RogerF5-Security/Case-Evil_Doggie/docs/PROTOTYPE_FEEDBACK.md

# Prototipo de taller

Estas fotografías documentan un **prototipo anterior de taller**. Los renders y
el visor muestran la geometría compartida, cuya impresión aún debe comprobarse.

| Observación del prototipo | Cambio en v2 |
|---|---|
| Letras exteriores poco legibles | Se retiran todas; se conserva la geometría interior existente |
| USB demasiado justo por su borde inferior | Recorte más ancho y 2 mm de rebaje adicional propuesto |
| Tornillos largos difíciles de conseguir | Eliminados: cierre con cuatro pestañas liberables |
| Ventilación insuficiente | Rejilla posterior de 14 ranuras + 8 laterales pasantes |
| DB9 visible y accesible | Se conserva su abertura nominal y su acceso |

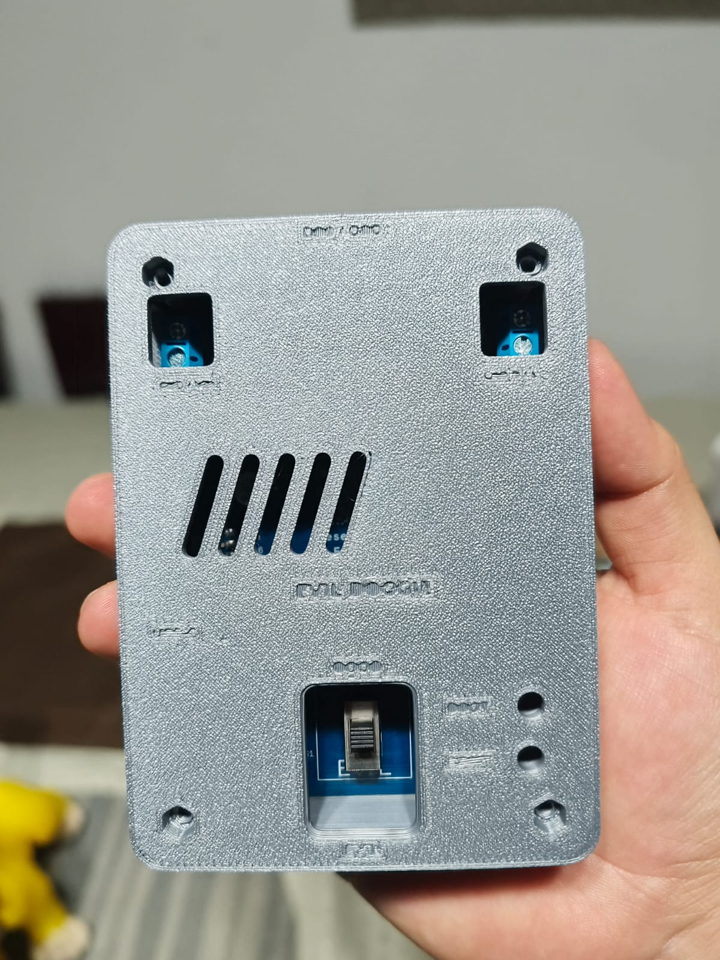
[picture p5: docs/photos/v1-controls.png]
Prototipo v1: controles y grabados pequeños


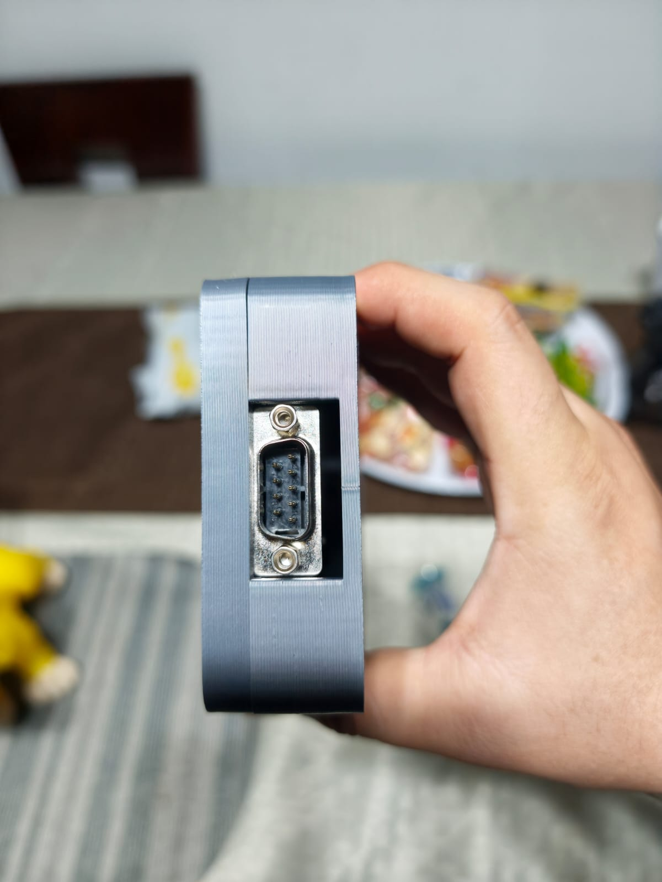
[picture p6: docs/photos/v1-db9.png]
Prototipo v1: acceso DB9


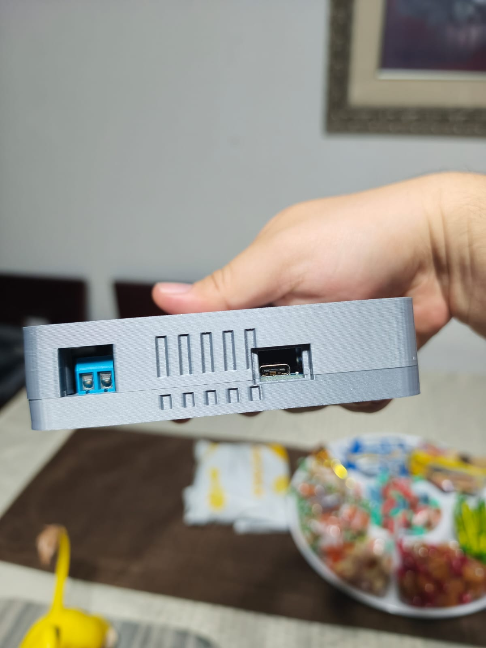
[picture p7: docs/photos/v1-usb.png]
Prototipo v1: abertura USB y rebajes laterales


La v1 tenía cinco rebajes de agarre en cada lateral; no eran pasos de aire.
El área abierta posterior de v2 se calcula directamente a partir del CAD.
El resultado térmico y la fuerza de las pestañas requieren pruebas reales.
