RogerF5-Security/Case-Evil_Doggie/assets/pcb-art.png

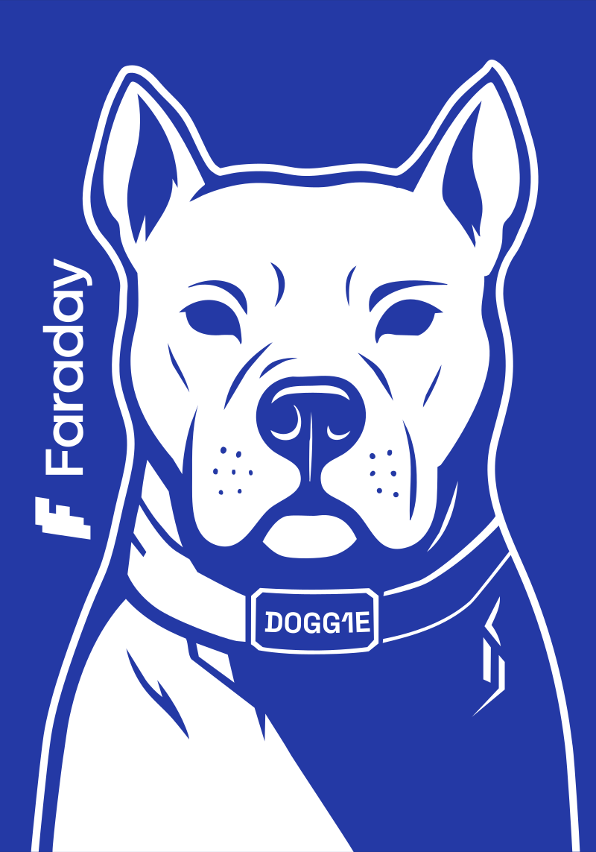
assets/pcb-art.png
