RogerF5-Security/Case-Evil_Doggie/docs/images/front.png

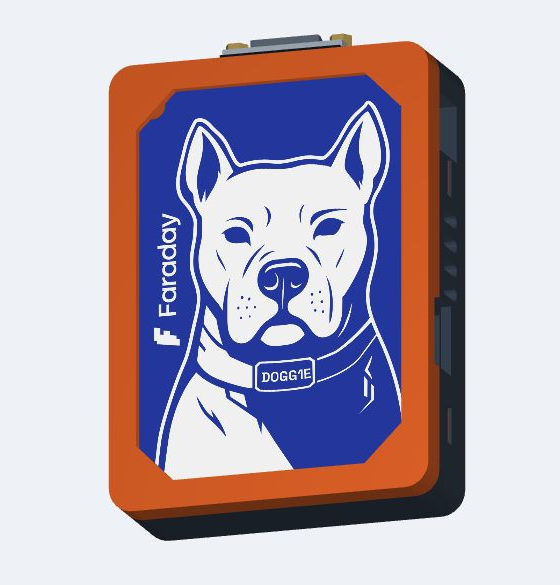
docs/images/front.png
