RogerF5-Security/Case-Evil_Doggie/docs/images/inside.png

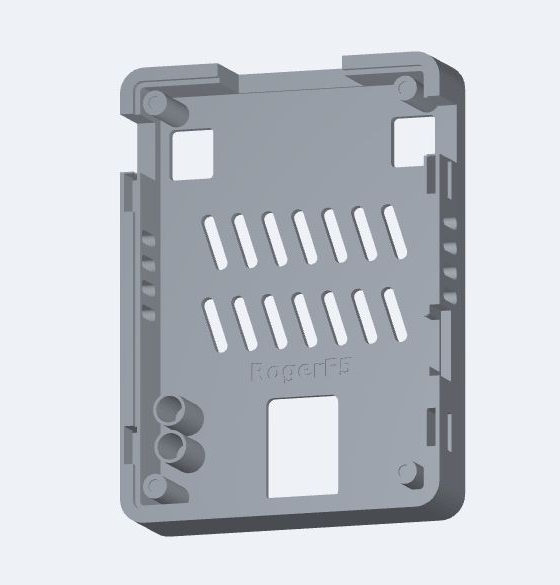
docs/images/inside.png
