RogerF5-Security/Case-Evil_Doggie/docs/images/rear.png

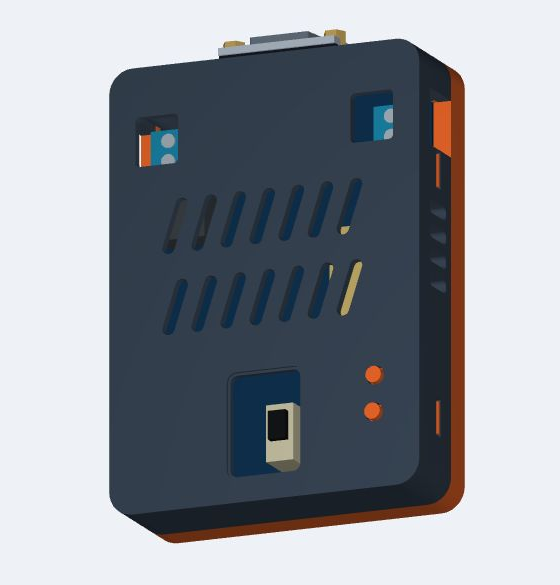
docs/images/rear.png
