RogerF5-Security/Case-Evil_Doggie/docs/images/signature.png

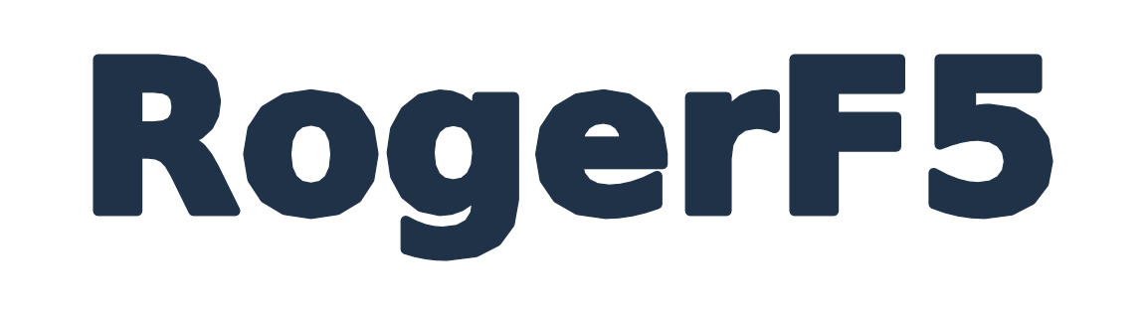
docs/images/signature.png
