RogerF5-Security/Case-Evil_Doggie/docs/images/usb-side.png

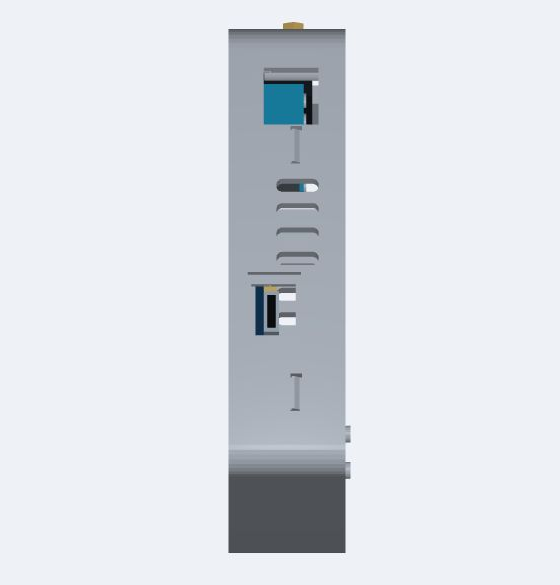
docs/images/usb-side.png
