RogerF5-Security/Case-Evil_Doggie/docs/images/viewer-front.png

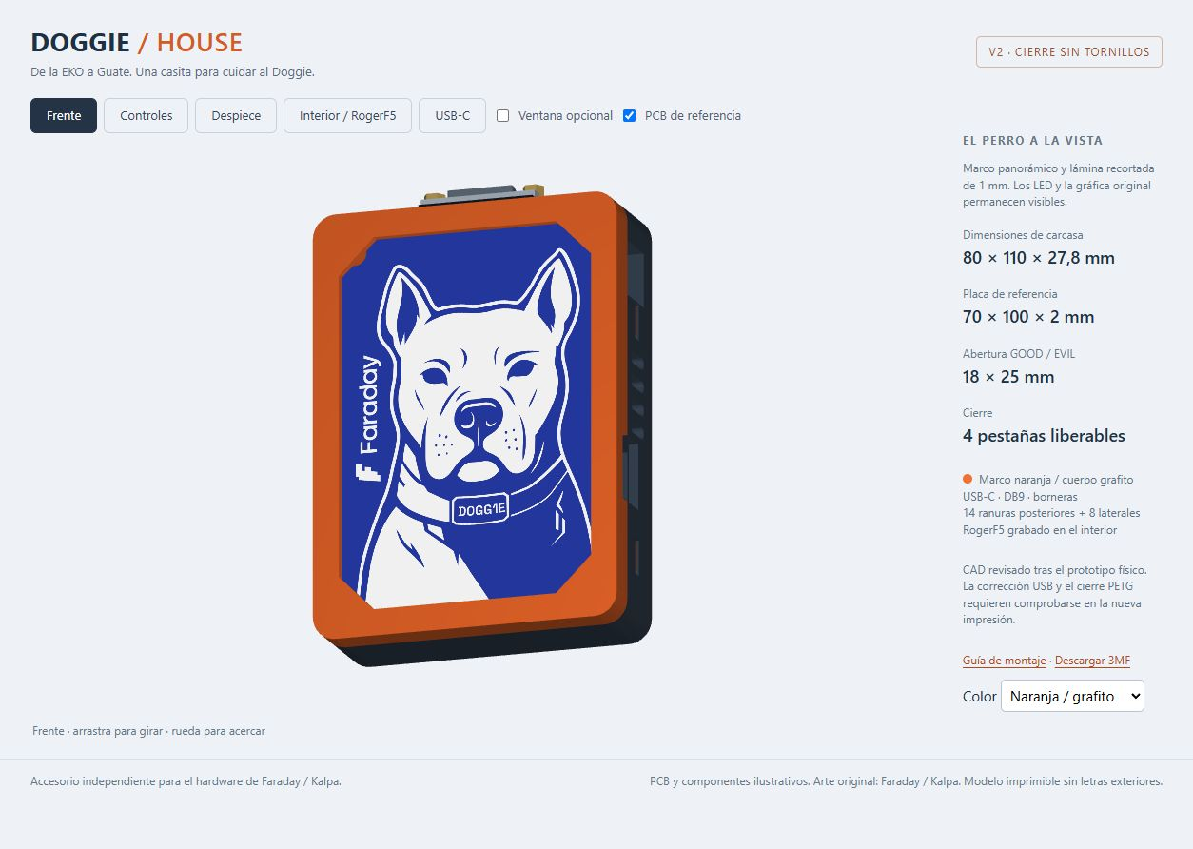
docs/images/viewer-front.png
