RogerF5-Security/Case-Evil_Doggie/docs/photos/PCB EvilDoggie en carcasa plateada.png

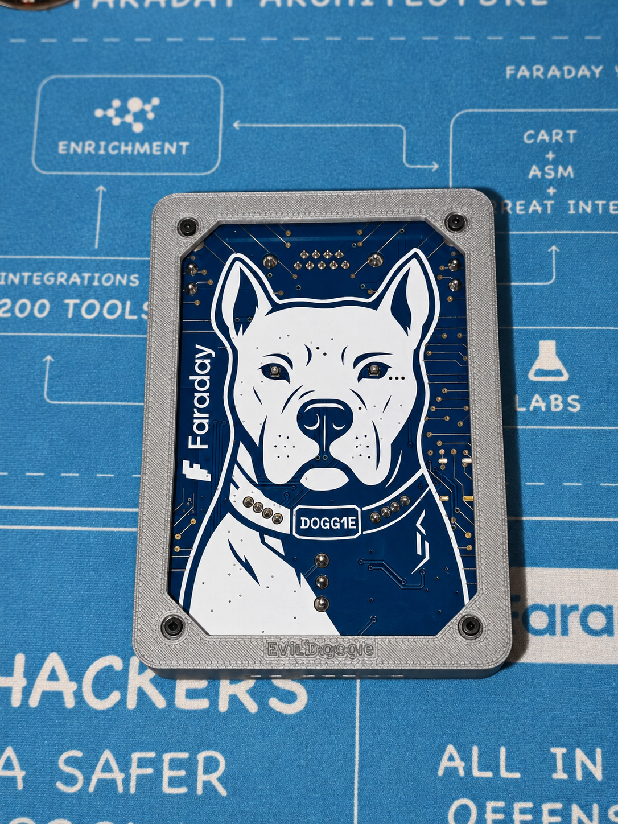
docs/photos/PCB EvilDoggie en carcasa plateada.png
