RogerF5-Security/Case-Evil_Doggie/docs/photos/Vista trasera de carcasa EvilDoggie.png

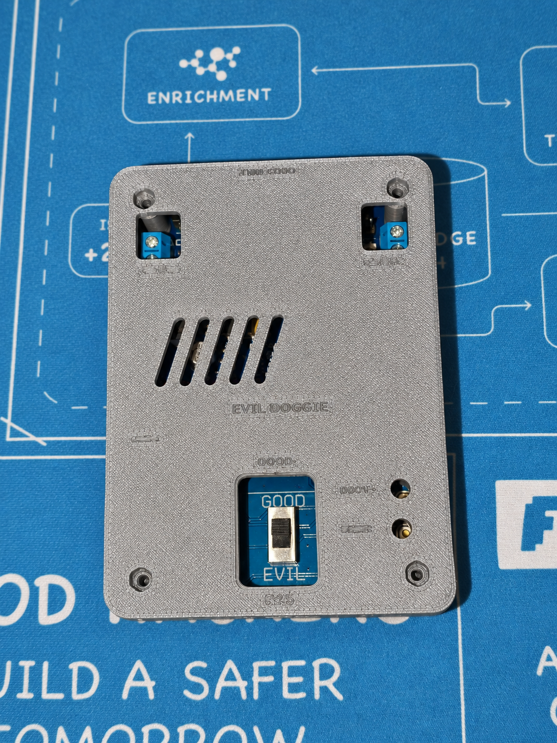
docs/photos/Vista trasera de carcasa EvilDoggie.png
