RogerF5-Security/Case-Evil_Doggie/models/doggie-house-standard.3mf

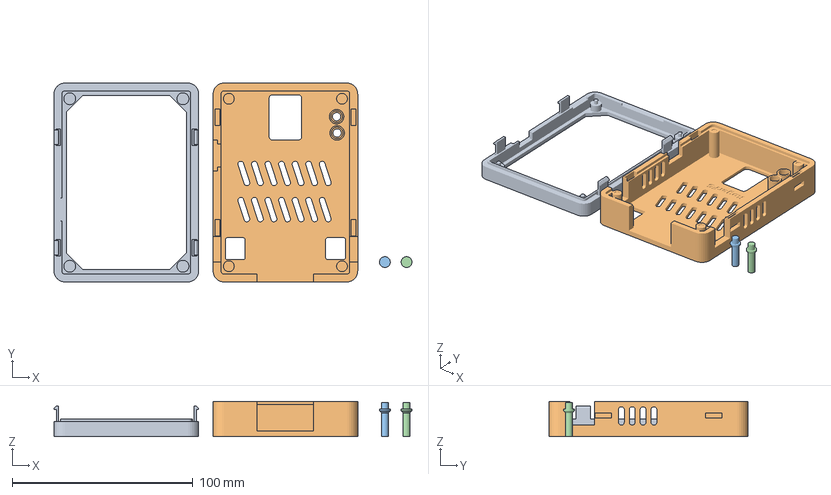
[picture p17: CAD file, 2026-11-05]
models/doggie-house-standard.3mf
198.0 x 110.0 x 19.4 mm
Front frame
Rear cover
Boot button
Reset button
