RogerF5-Security/Case-Evil_Doggie/models/stl/11_usb_test_rear.stl

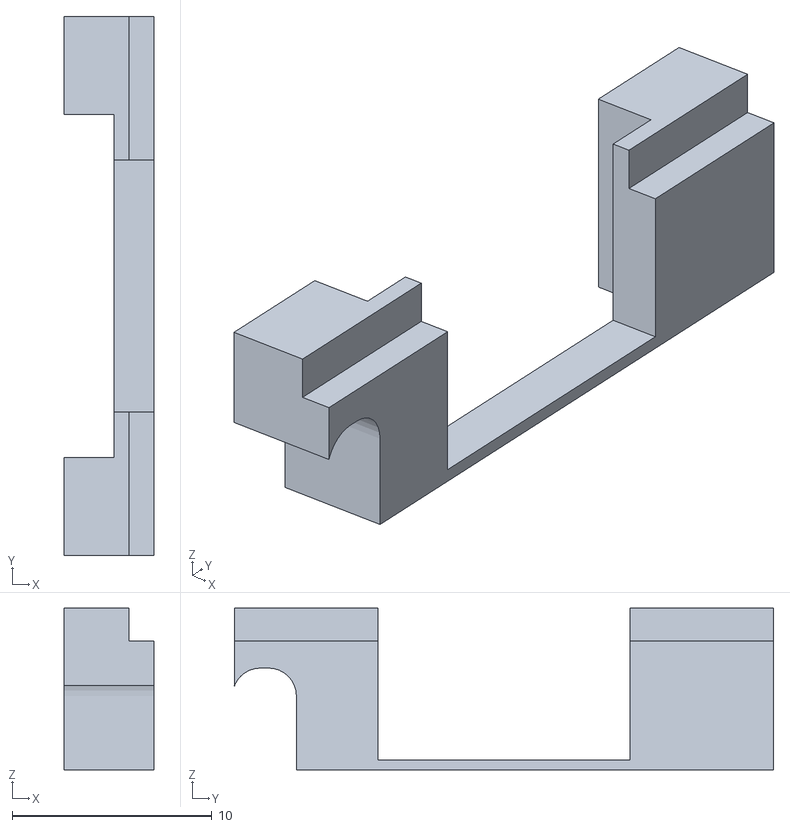
[picture p18: CAD file, 2026-11-05]
models/stl/11_usb_test_rear.stl
4.50 x 27.0 x 8.10
