RogerF5-Security/Case-Evil_Doggie/models/doggie-house-direct-access.3mf

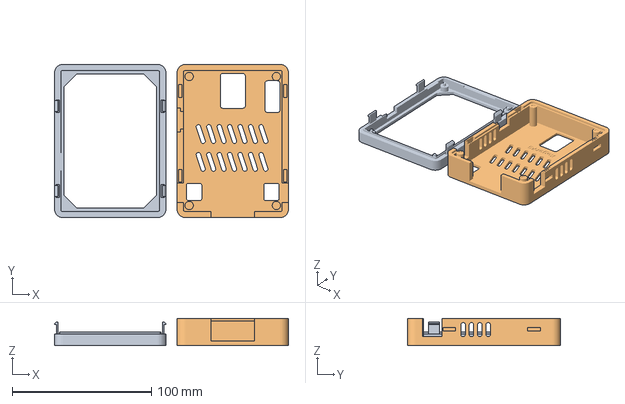
[picture p19: CAD file, 2026-11-05]
models/doggie-house-direct-access.3mf
168.0 x 110.0 x 19.4 mm
Front frame
Direct-access cover
