RogerF5-Security/Case-Evil_Doggie/models/stl/05_pcb_fit_template.stl

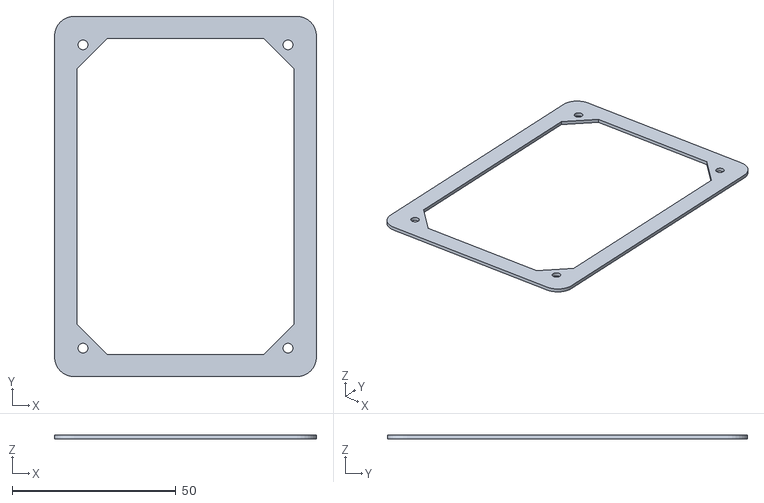
[picture p20: CAD file, 2026-11-05]
models/stl/05_pcb_fit_template.stl
80.0 x 110.0 x 1.20
