RogerF5-Security/Case-Evil_Doggie/models/stl/08_snap_test_front.stl

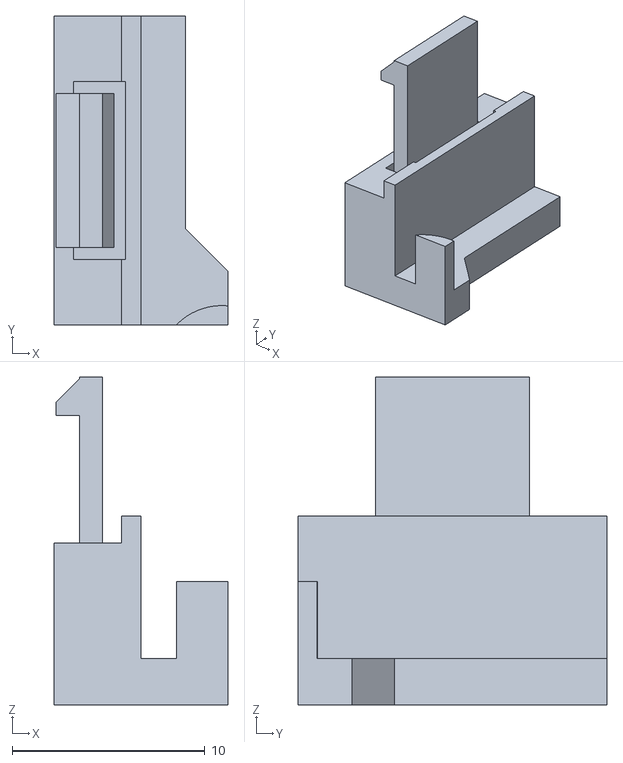
[picture p21: CAD file, 2026-11-05]
models/stl/08_snap_test_front.stl
9.00 x 16.0 x 17.0
