RogerF5-Security/Case-Evil_Doggie/models/stl/06_controls_template.stl

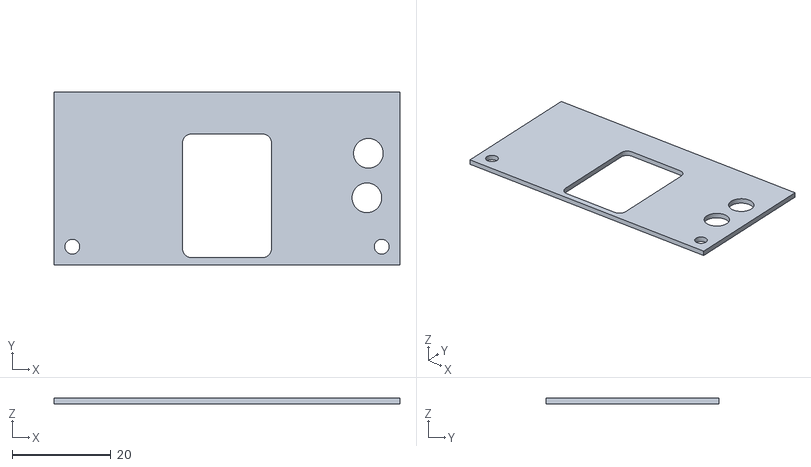
[picture p22: CAD file, 2026-11-05]
models/stl/06_controls_template.stl
70.0 x 35.0 x 1.20
