RogerF5-Security/Case-Evil_Doggie/models/stl/01_front_frame.stl

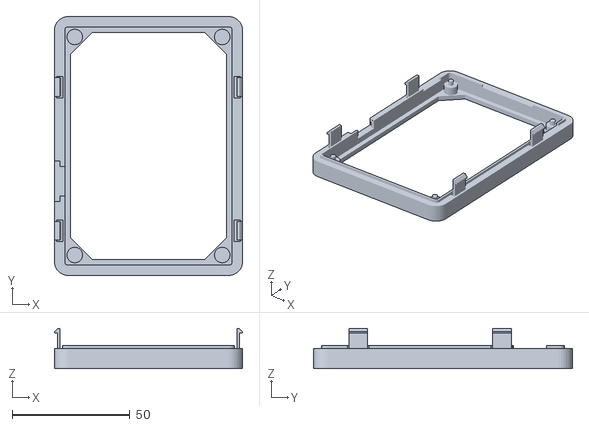
[picture p23: CAD file, 2026-11-05]
models/stl/01_front_frame.stl
80.0 x 110.0 x 17.0
