RogerF5-Security/Case-Evil_Doggie/models/stl/04_rear_direct_access_optional.stl

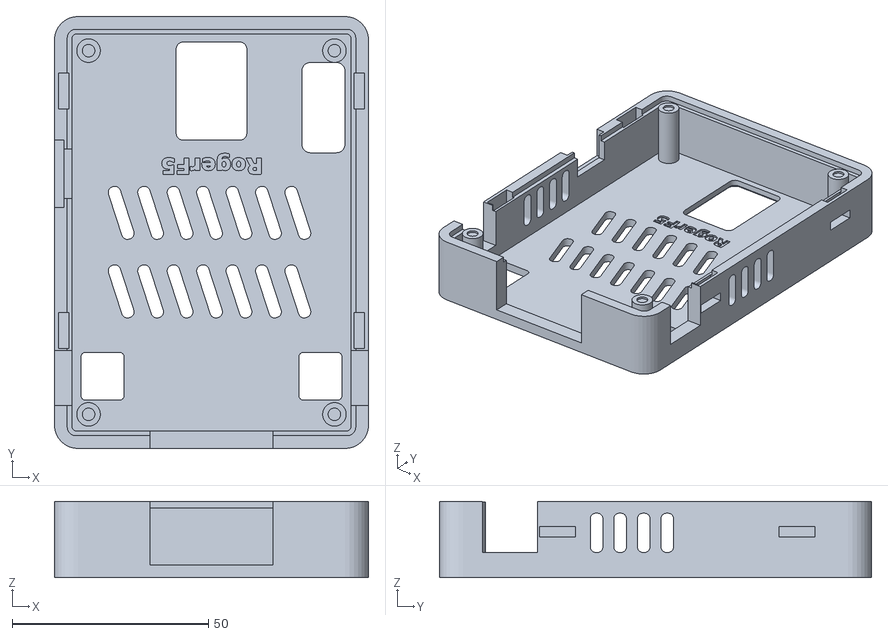
[picture p24: CAD file, 2026-11-05]
models/stl/04_rear_direct_access_optional.stl
80.0 x 110.0 x 19.4
