RogerF5-Security/Case-Evil_Doggie/models/stl/07_clearance_coupon.stl

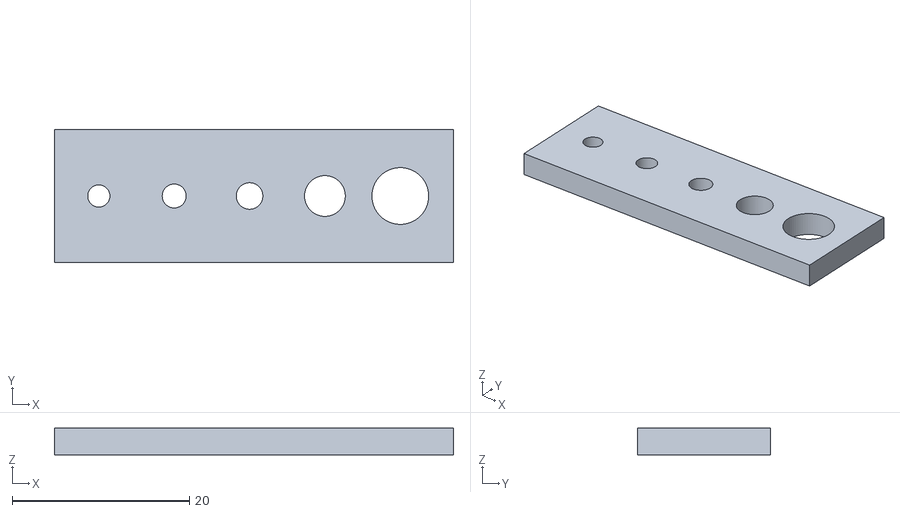
[picture p25: CAD file, 2026-11-05]
models/stl/07_clearance_coupon.stl
45.0 x 15.0 x 3.00
