RogerF5-Security/Case-Evil_Doggie/models/stl/03_two_captive_buttons.stl

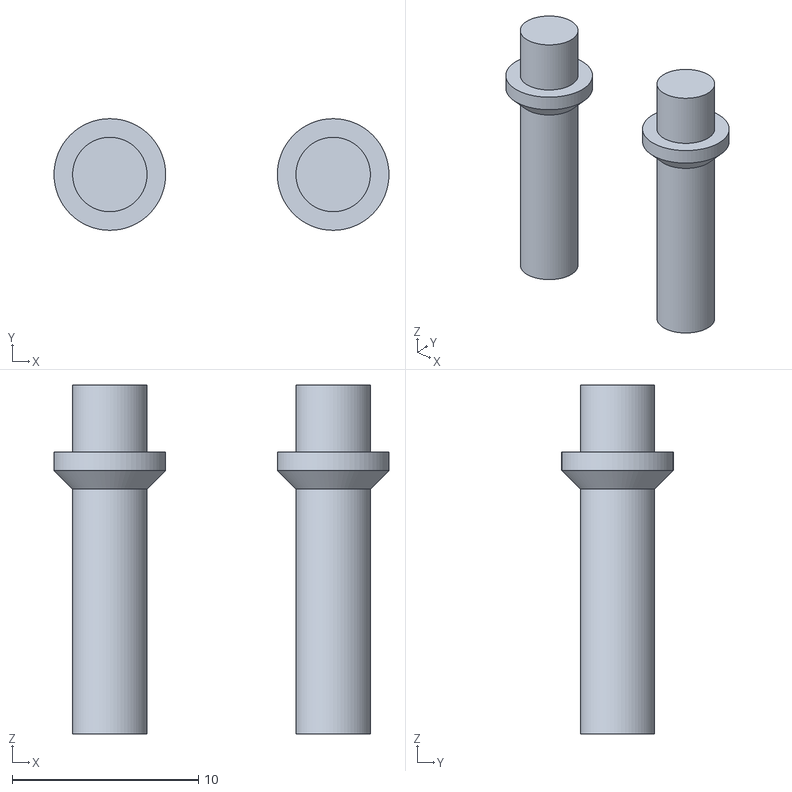
[picture p26: CAD file, 2026-11-05]
models/stl/03_two_captive_buttons.stl
18.0 x 6.00 x 18.8
