RogerF5-Security/Case-Evil_Doggie/models/stl/09_snap_test_rear.stl

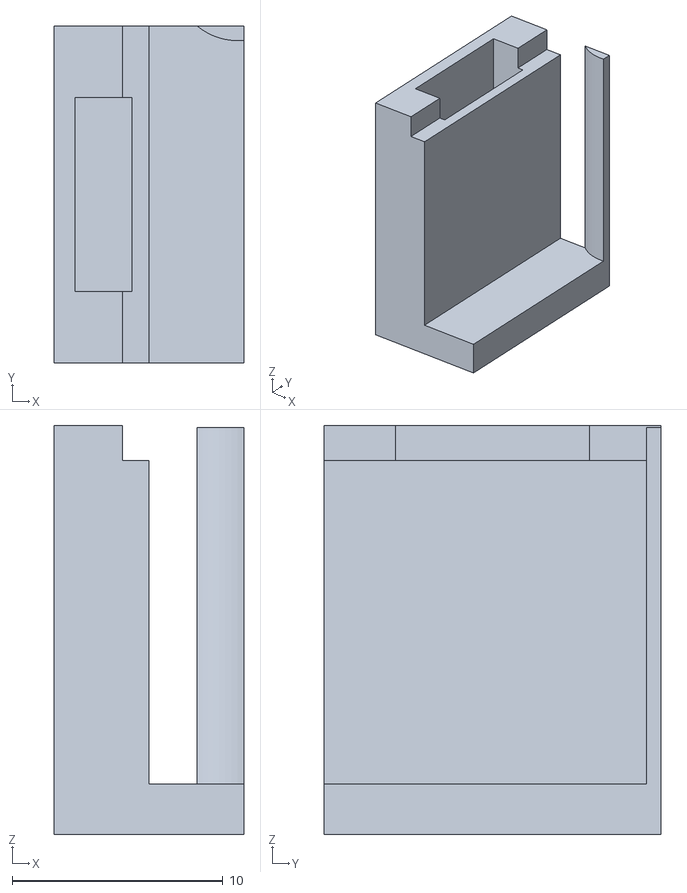
[picture p27: CAD file, 2026-11-05]
models/stl/09_snap_test_rear.stl
9.00 x 16.0 x 19.4
