RogerF5-Security/Case-Evil_Doggie/models/stl/02_rear_cover.stl

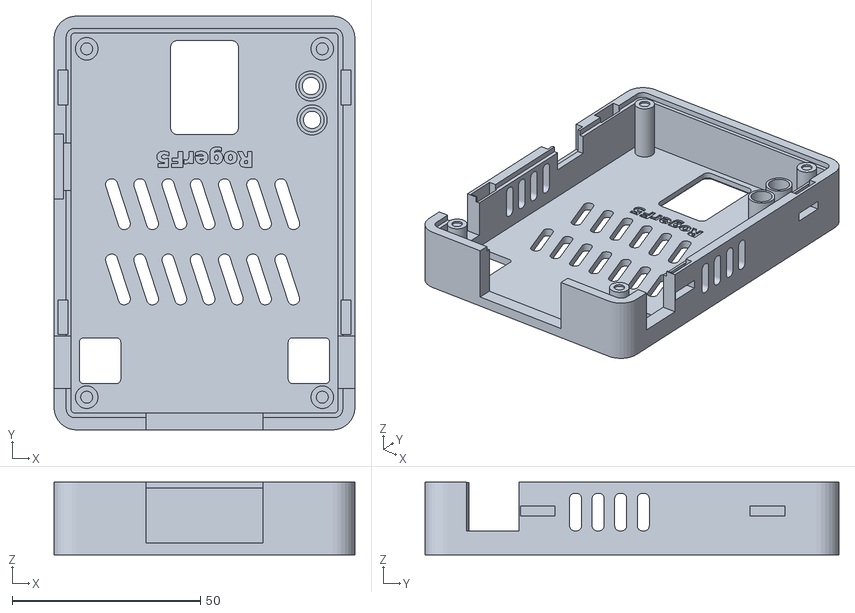
[picture p28: CAD file, 2026-11-05]
models/stl/02_rear_cover.stl
80.0 x 110.0 x 19.4
