RogerF5-Security/Case-Evil_Doggie/models/stl/10_usb_test_front.stl

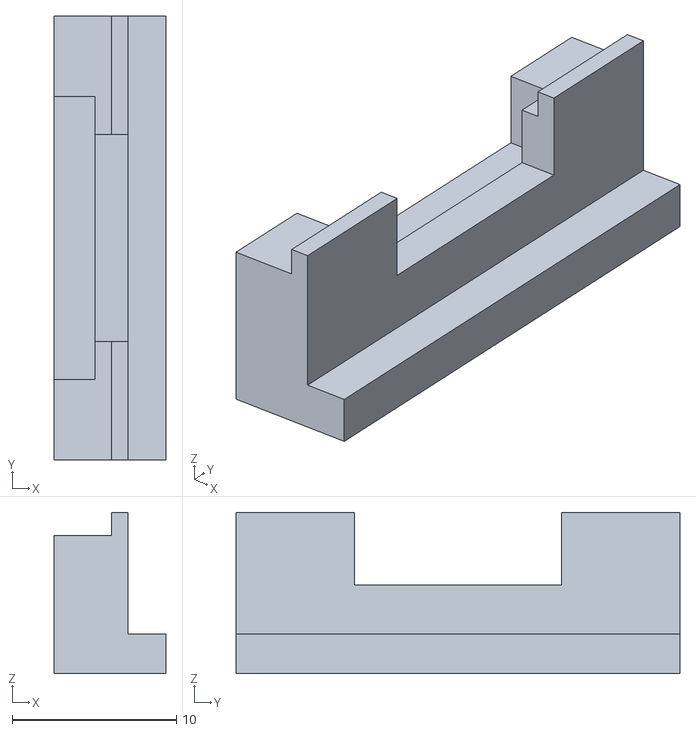
[picture p29: CAD file, 2026-11-05]
models/stl/10_usb_test_front.stl
6.80 x 27.0 x 9.80
