RogerF5-Security/Case-Evil_Doggie/models/stl/12_signature_test.stl

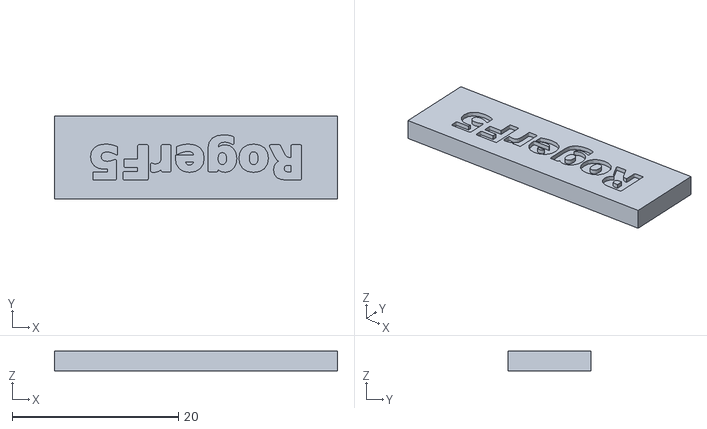
[picture p30: CAD file, 2026-11-05]
models/stl/12_signature_test.stl
34.0 x 10.0 x 2.40
