RogerF5-Security/Case-Evil_Doggie/CHANGELOG.md

# Publicaciones

## 1.0.0 - 2026-11-05

Primera publicación comunitaria de Doggie House, una carcasa para cuidar EvilDoggie.

- STL y disposiciones 3MF para la tapa con pulsadores cautivos y la alternativa de acceso directo.
- Marco que mantiene visibles el perro y los LED, cierre sin tornillos y acceso a conexiones y controles.
- Muestras de cierre y USB, plantillas de ajuste y ventana transparente opcional.
- Guías de impresión, ensamblaje y mantenimiento en español e inglés; PDF ilustrado.
- Sitio GitHub Pages con historia, descargas, montaje y visor 3D HTML sin dependencias externas.
- Modelado en Kraken Tres D, a partir del EvilDoggie regalado por los amigos de Faraday en EKOparty 2026, Argentina.

La edición pública 1.0.0 conserva sin cambios los modelos existentes y su revisión interna de taller `2.0.0-rc1`. Las comprobaciones digitales están en `docs/validation.json`. El ajuste físico de la geometría compartida se registra por separado en `docs/RELEASE_CHECKLIST.md`.
