RogerF5-Security/Case-Evil_Doggie/(commit log)

2026-11-05 Publish Doggie House community edition with assembly guide and 3D site
2026-11-05 Keep assembly navigation outside the embedded 3D viewer
